rodriguesfas/claw/README.md

# claw
claw arduio
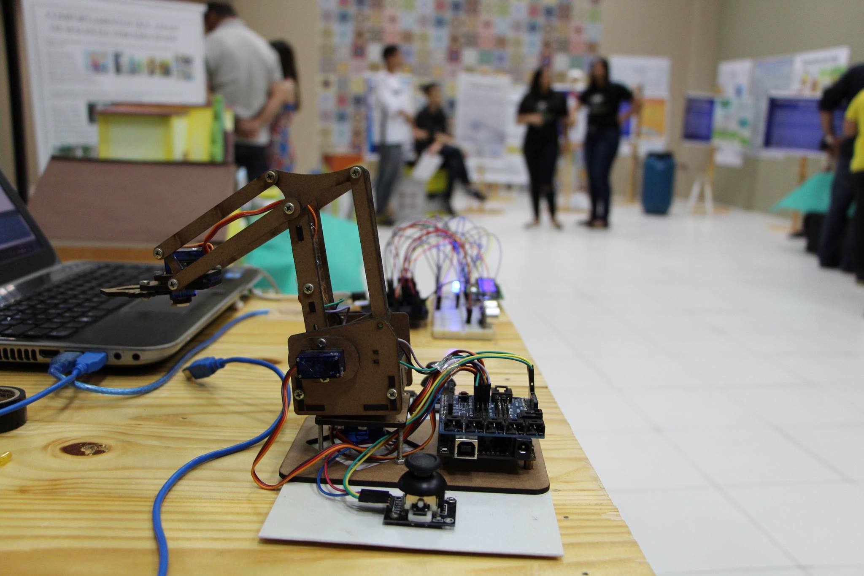
[picture p1: img/claw.jpg]


#Credits
