rodriguesfas/claw/img/2016-08-03 10.52.49.jpg

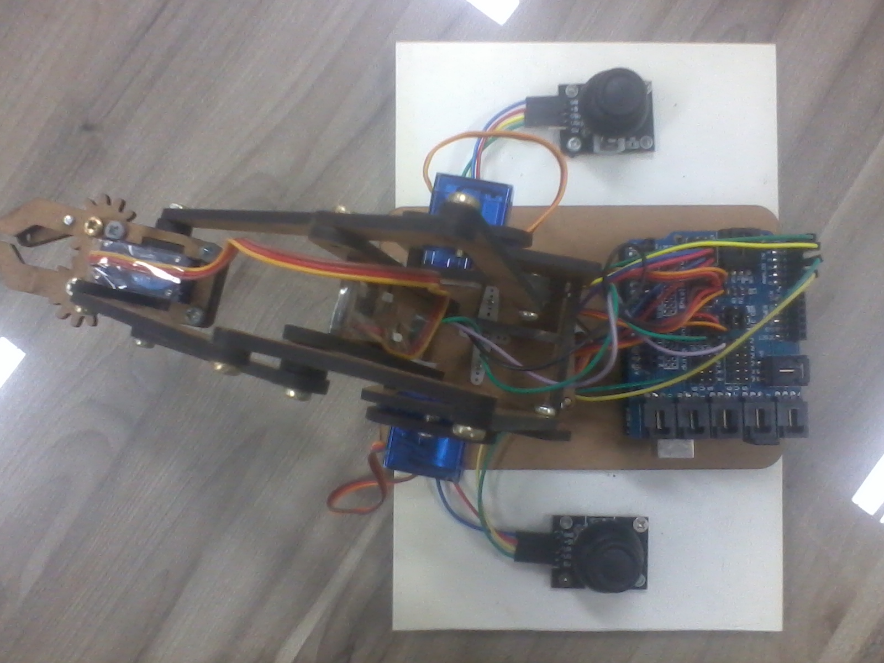
img/2016-08-03 10.52.49.jpg
