rodriguesfas/claw/img/2016-08-03 10.52.57.jpg

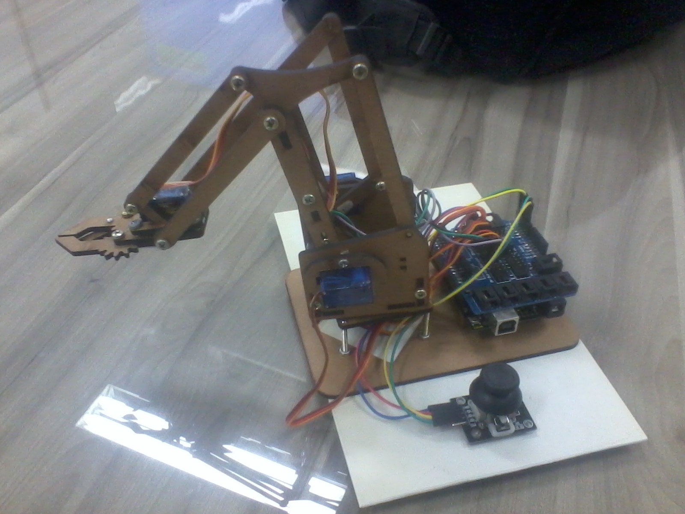
img/2016-08-03 10.52.57.jpg
