rodriguesfas/claw/img/2016-08-03 10.53.03.jpg

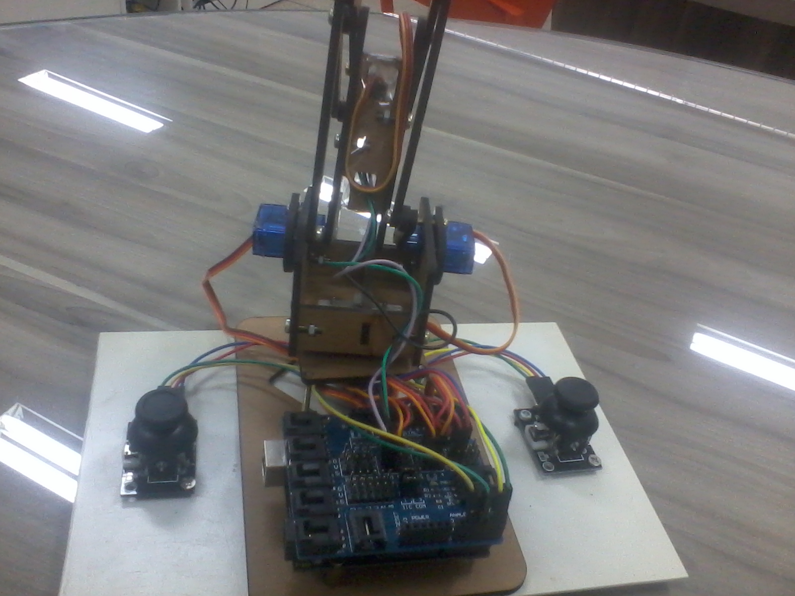
img/2016-08-03 10.53.03.jpg
